Tamakichi/Ichigoepprom3/img/01.jpg

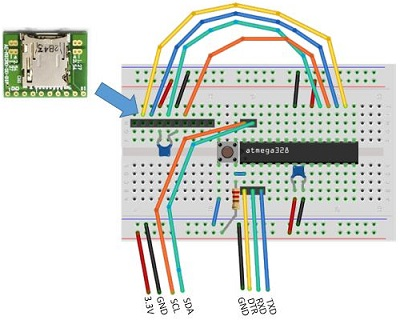
img/01.jpg
