Tamakichi/Ichigoepprom3/img/03.jpg

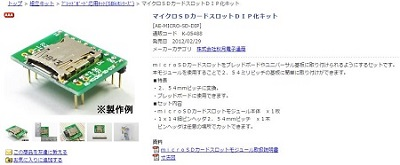
img/03.jpg
