Tamakichi/Ichigoepprom3/(threads)

Thread 1 (2018-08-09):

IchigoJa,m 1.2.2以降ではLOADが正常動作しない

Tamakichi, 2018-08-09:
IchigoJam 1.2.1で動いていたのに、1.2b59にアップデートすると正常動作しなくなります。I2Cクロック100k、400kも試すもダメでした。
1.2.3、1.2.2も試しましたが動きません。1.2.1では利用出来ます。

FILES、SAVEはちゃんと出来るけど、LOADがダメでIchigoJamからの1024バイト分の32バイトx32回のデータ取得が3回で必ずいつも止まります。IchigoJamからの4回目の読み込みリクエストが来ません。

I2Cパケットを調べると、EEPROMへのLOAD時、差異が見られます。
ただし、両方のバージョンとも正常に動作しました。
ichigojam1 2 1
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
ichigojam1 2b59
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

v1.2.1では、EEPROMのデータシートに記載されているシーケンシャル読み込み通りの
プロトコルにてデータの読み込みが行われています。

一方、v1.2b59のでは、
スタートビット（緑の立下り）の直後にストップビット（赤の立下り）、さらにその直後に
スタートビット（緑の立下り）がIchigoJamから送信されています。
SCLの１クロック内でスタートビットとストップビットがあるのも謎です。

Ichigojamの方に問題があるようですが、I2C EEPROMの利用では問題無いので、
不具合とも言えないです。
