Tamakichi/Ichigoepprom3/(commit log)

2016-12-23 参照ブログの追加
2016-12-23 ドキュメント用画像追加
2016-12-23 画像追加
2016-12-23 ディレクトリ構成変更
2016-12-23 ディレクトリ構成変更のため削除
2016-12-23 ドキュメント初版
2016-12-23 デバッグ情報出力無効に修正
2016-12-28 不要なヘッダーファイル読込の削除
2016-12-30 ドキュメント記載ミス訂正
2018-08-09 Ichigojam 1.2.2以降未対応記載追記
